adzmir32/esc/(commit log)

2026-11-01 Add ESC bring-up documentation
2026-11-02 Add board images
